bR3iN/YM60JIS/(commit log)

2026-08-23 address warnings
    [YM60JIS_PCB.kicad_pcb]
2026-08-23 remove microvial
    [YM60JIS_PCB.kicad_pcb]
2026-08-23 exported production files
    [YM60JIS_PCB-B_Cu.gbl, YM60JIS_PCB-B_Mask.gbs, YM60JIS_PCB-B_Paste.gbp, YM60JIS_PCB-B_Silkscreen.gbo, YM60JIS_PCB-Edge_Cuts.gm1, YM60JIS_PCB-F_Cu.gtl, YM60JIS_PCB-F_Mask.gts, YM60JIS_PCB-F_Paste.gtp]
2026-10-27 snapshot: 2026-10-27 20:32:09+01:00
    [YM60JIS_PCB.kicad_pcb, YM60JIS_PCB.kicad_sch, plate2.kicad_pcb, plate2.kicad_sch]
2026-10-27 chore: cleanup fork
    [Plate.kicad_pcb, Plate.kicad_sch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]
2026-10-27 feat: add footprint library for SK8707-01
